STU-BLUESKY/Airplane/0、项目介绍/第一代无人机.jpg

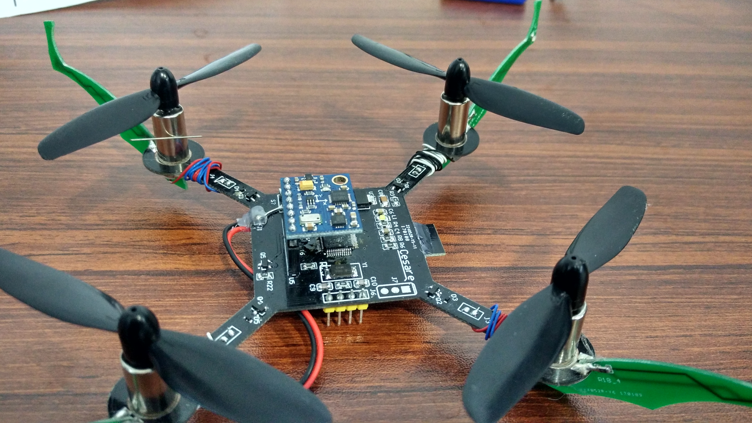
0、项目介绍/第一代无人机.jpg
