STU-BLUESKY/Airplane/3、无人机架构/无人机三代支架/效果图/机身.jpg

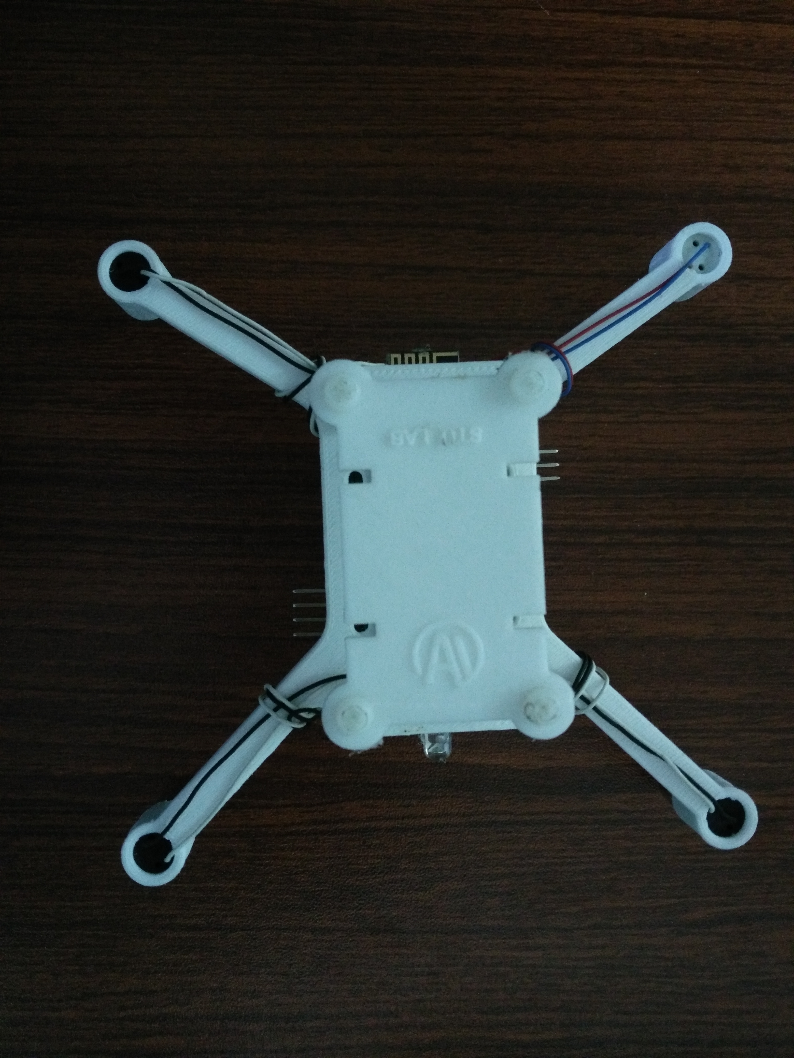
3、无人机架构/无人机三代支架/效果图/机身.jpg
