STU-BLUESKY/Airplane/5、宣传资料/安防无人机申报答辩PPT.pptx

基于STM32的安防无人机

负责人： 潘蓝根 团队成员：段一鸣 黄宇荣

## Slide 2

CONTENTS

目 录

ABOUT OUR TEAM

我们的分工

ABOUT OUR PREPERATION

项目前期准备

项目创新点

ABOUT OUR PLAN

实施方案

ATICIPATE RESULT

预期成果

FUTURE

经费预算

INNOVATION PIONT

## Slide 3

THE FIRST PART

我们的团队
ABOUT OUR TEAM

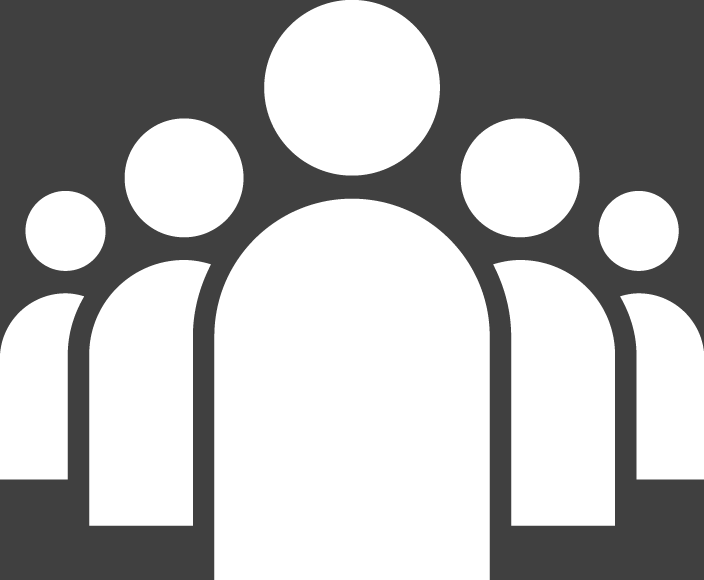
[picture p3: figure]

潘蓝根

15级电子信息工程
负责底层软件的开发

段一鸣

15级电子信息工程
电路设计

黄宇荣

15级电子信息工程
图像回传

## Slide 4

THE SECOND PART

前期准备
ABOUT OUR PREPARETION

①上网查找资料
(包括无人机行业的发展、无人机现状，开发无人机的关键技术和难点)
②分析项目可行性
③讨论项目进度安排、人员分工
④了解大概成本
⑤整理申报书

## Slide 5

THE THIRD PART

创新点
INNOVATION PIONT

创新难度

项目的创新点
1、配套遥控器，操作简单
2、成本低，功能比较全面
3、飞行稳定，安全性高

1

2

3

30%

50%

20%

## Slide 6

THE FOURTH PART

实施方案
STARTING PLAN

STEP ONE

STEP TWO

学习相关知识

搭建实验板

设计电路板

我们的计划
WHAT IS OUR PLAN

STEP THREE

STEP FOUR

开发底层软件，实现空中悬停（中期目标）

实现无人机的前后左右飞行

STEP FIVE

STEP SIX

开启摄像头，实现图像回传

## Slide 7

THE FOURTH PART

预期效果
ATICIPATE RESULT

1

实现无人机空中悬停

2

实现无人机的前后左右飞行

3

实现图像回传

## Slide 8

THE THIRD PART

经费预算
OUTLAY

任务 | | 经费（元）
实验板搭建，电子元器件的购买 | | 800
PCB板制作 | | 400
STM32学习板 | | 300
电池 | | 200
学习书籍购买 | | 100
其他 | | 100
总计 | | 1900

## Slide 9

THE FOURTH PART

可行性分析
FEASIBILITY ANALYSE

1

2

3

团队成员都有项目经验，对于项目的开发流程已经有了充分的了解

团队成员对无人机开发充满着兴趣，并且已经有了一定的无人机开发经验

本项目技术方案是在前人的基础上再进行改进，技术方案可行

## Slide 10

Q & A

THANK YOU
FOR WATCHING
