STU-BLUESKY/Airplane/0、项目介绍/第二代无人机.jpg

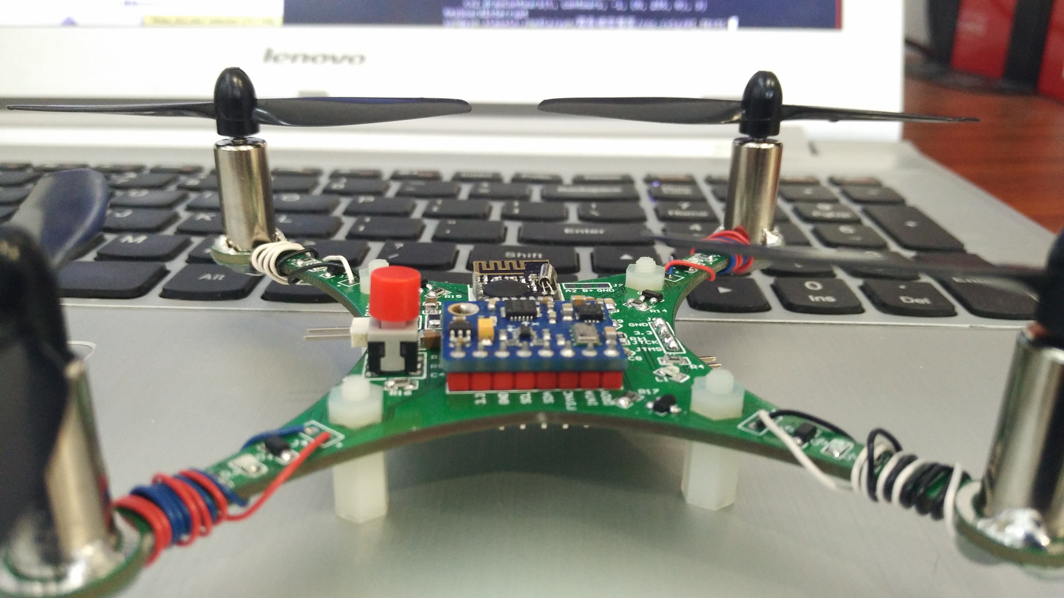
0、项目介绍/第二代无人机.jpg
