STU-BLUESKY/Airplane/0、项目介绍/遥控器.jpg

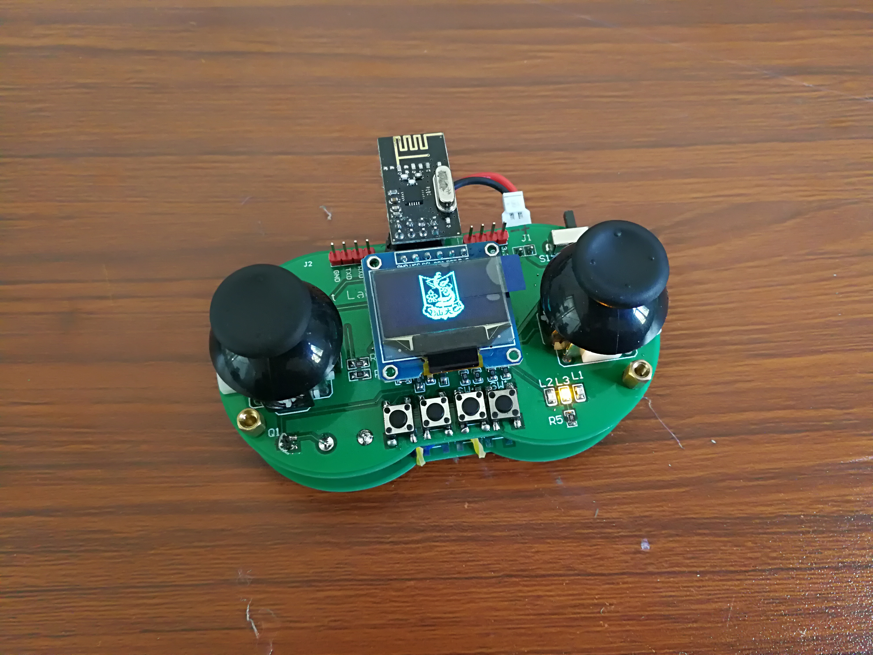
0、项目介绍/遥控器.jpg
