STU-BLUESKY/Airplane/3、无人机架构/无人机三代支架/效果图/支架05.PNG

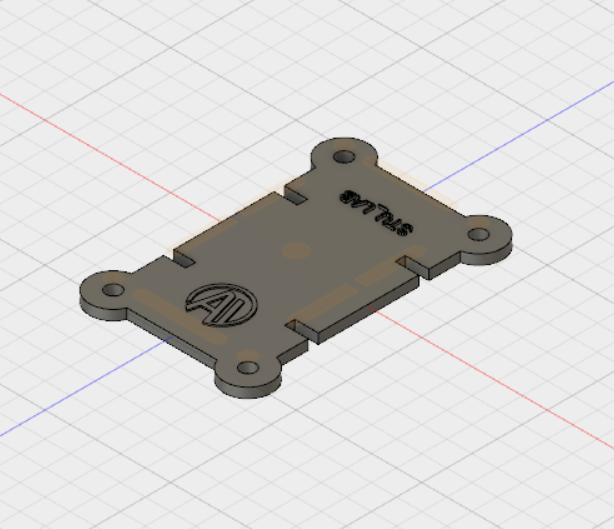
3、无人机架构/无人机三代支架/效果图/支架05.PNG
