STU-BLUESKY/Airplane/3、无人机架构/无人机二代支架/效果图/QQ图片20180321143831.jpg

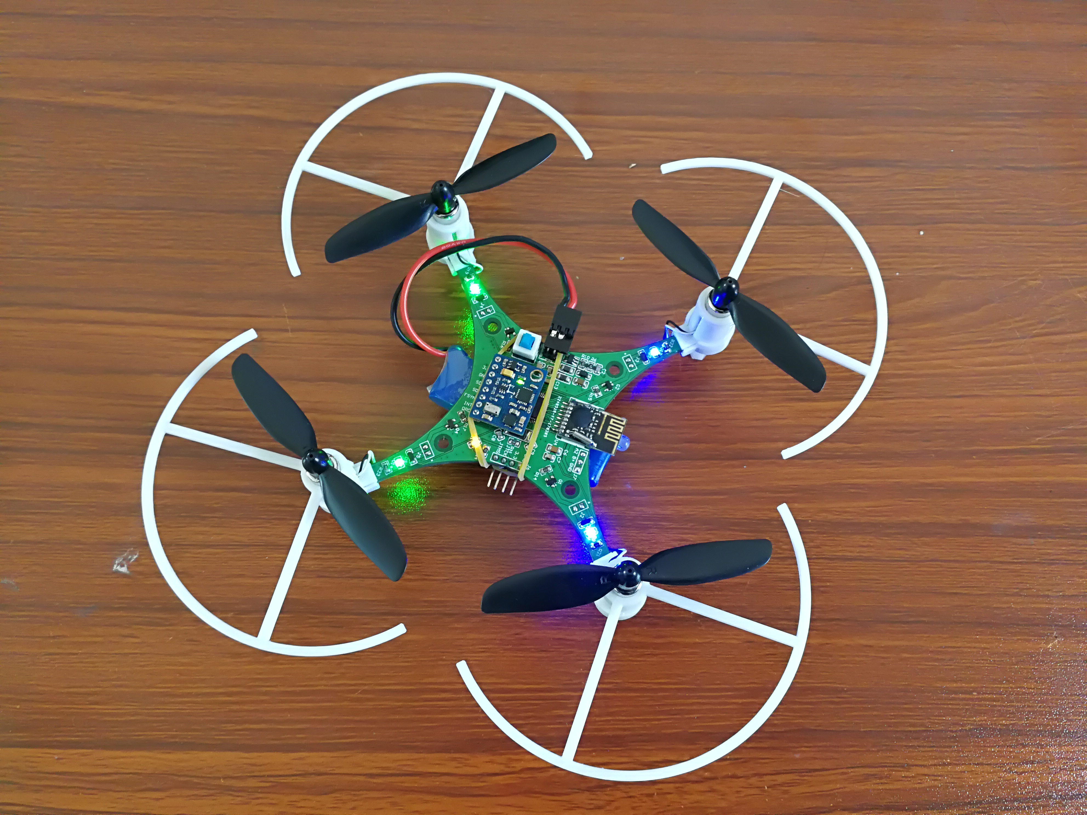
3、无人机架构/无人机二代支架/效果图/QQ图片20180321143831.jpg
