STU-BLUESKY/Airplane/3、无人机架构/无人机二代支架/效果图/支架02.PNG

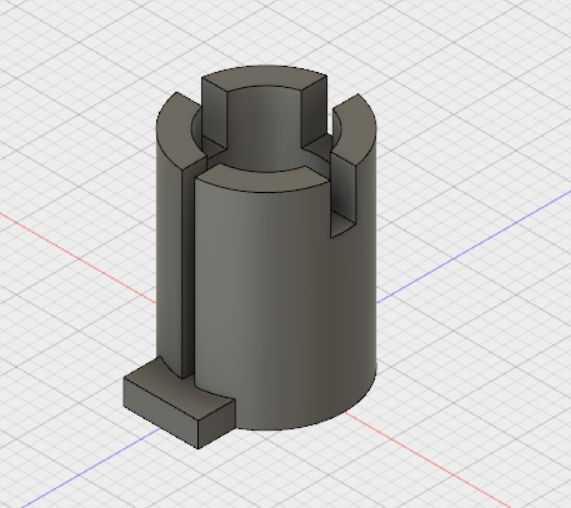
3、无人机架构/无人机二代支架/效果图/支架02.PNG
