STU-BLUESKY/Airplane/5、宣传资料/图片/1.PNG

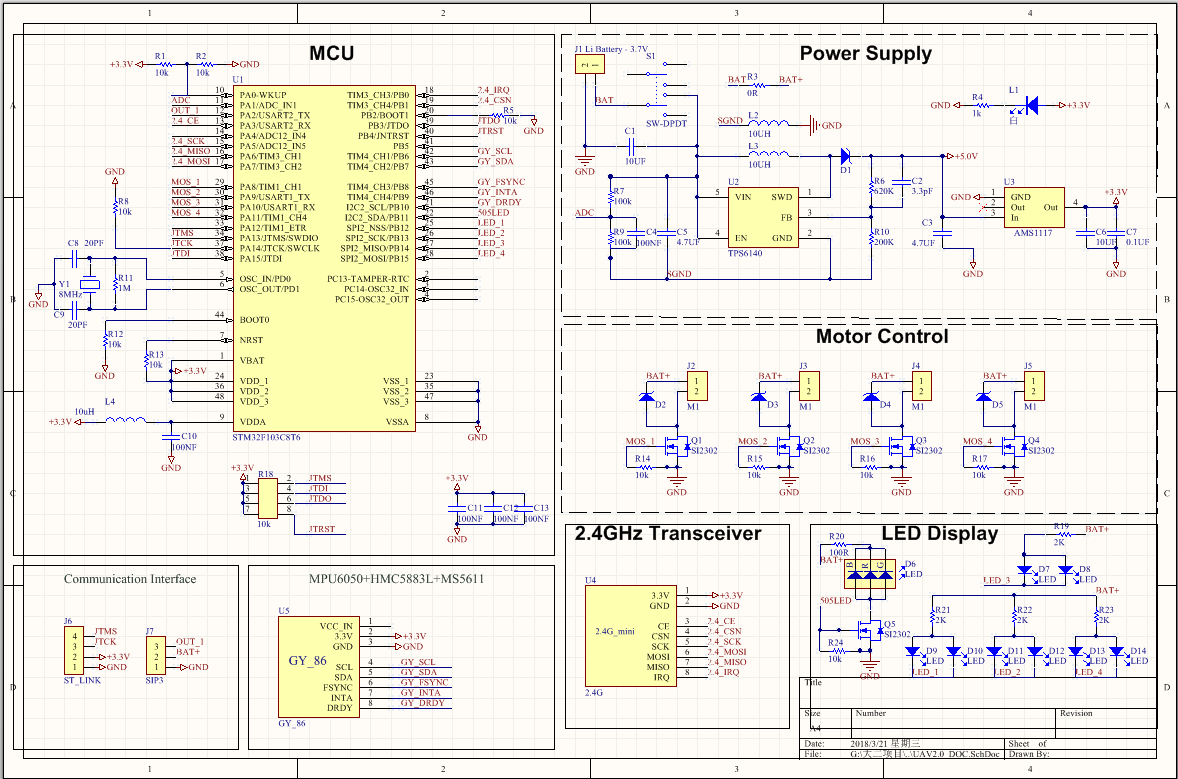
5、宣传资料/图片/1.PNG
