STU-BLUESKY/Airplane/5、宣传资料/图片/IMG_20180321_162717.jpg

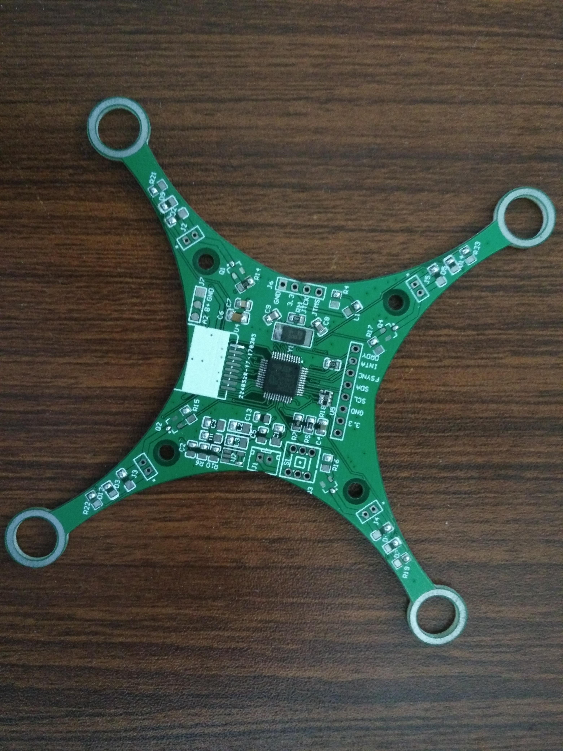
5、宣传资料/图片/IMG_20180321_162717.jpg
