STU-BLUESKY/Airplane/3、无人机架构/无人机三代支架/四轴支架.stl

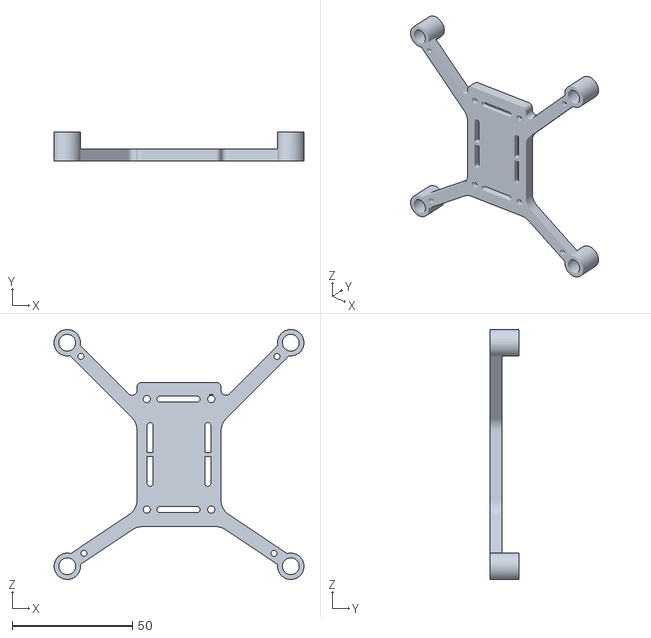
[picture p15: CAD file, 2018-04-16]
3、无人机架构/无人机三代支架/四轴支架.stl
103.9 x 12.0 x 103.9
