STU-BLUESKY/Airplane/3、无人机架构/无人机二代支架/STL模型/四轴护罩部件02.stl

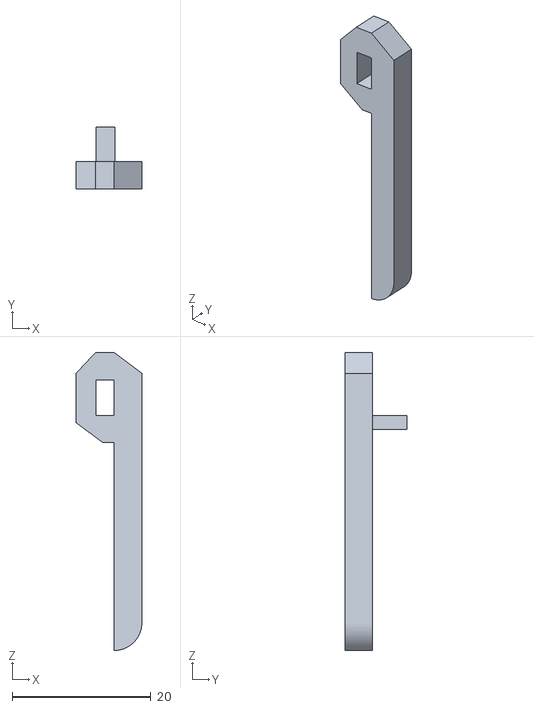
[picture p16: CAD file, 2018-04-16]
3、无人机架构/无人机二代支架/STL模型/四轴护罩部件02.stl
9.50 x 9.00 x 43.0
