STU-BLUESKY/Airplane/3、无人机架构/无人机二代支架/STL模型/四轴电机支架部件02.stl

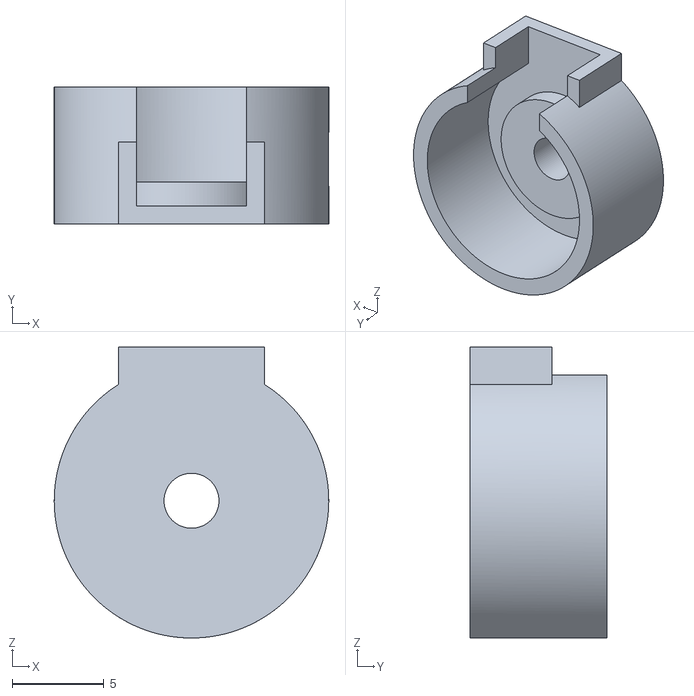
[picture p17: CAD file, 2018-04-16]
3、无人机架构/无人机二代支架/STL模型/四轴电机支架部件02.stl
15.0 x 7.50 x 15.9
