STU-BLUESKY/Airplane/3、无人机架构/无人机二代支架/STL模型/四轴电机支架部件01.stl

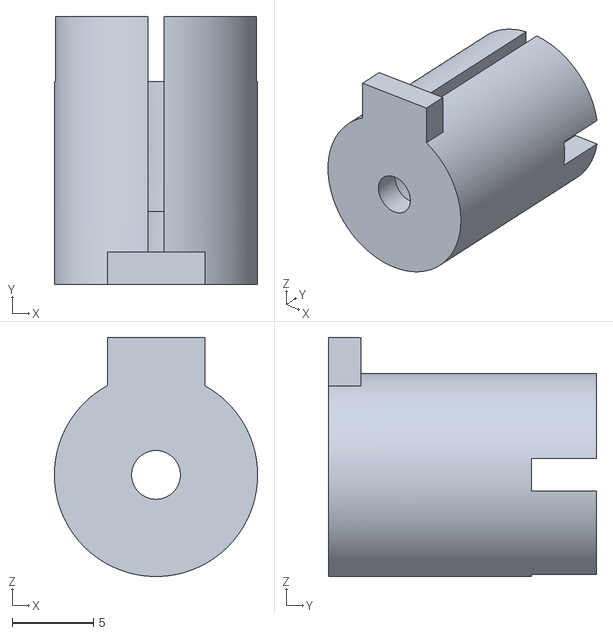
[picture p18: CAD file, 2018-04-16]
3、无人机架构/无人机二代支架/STL模型/四轴电机支架部件01.stl
12.5 x 16.5 x 14.7
