STU-BLUESKY/Airplane/3、无人机架构/无人机二代支架/STL模型/四轴护罩部件01.stl

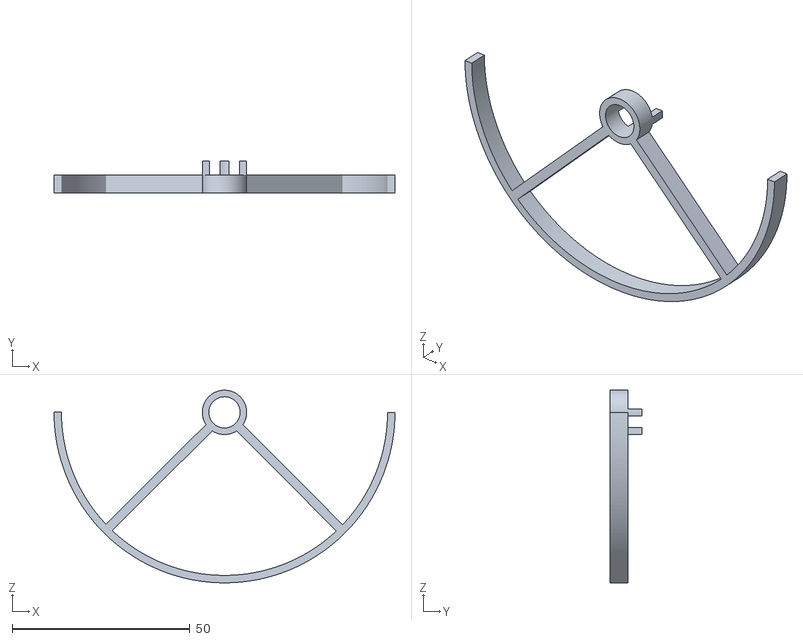
[picture p19: CAD file, 2018-04-16]
3、无人机架构/无人机二代支架/STL模型/四轴护罩部件01.stl
96.0 x 9.00 x 54.2
