STU-BLUESKY/Airplane/(list of files, cad)

Other CAD files:
3、无人机架构/无人机三代支架/四轴三代电池底板.f3d
3、无人机架构/无人机二代支架/AutodeskFusion360源文件/四轴护罩部件01.f3d
3、无人机架构/无人机二代支架/AutodeskFusion360源文件/四轴护罩部件02.f3d
3、无人机架构/无人机二代支架/AutodeskFusion360源文件/四轴电机支架部件01.f3d
3、无人机架构/无人机二代支架/AutodeskFusion360源文件/四轴电机支架部件02.f3d
