STU-BLUESKY/Airplane/(list of files, drawings)

Other design files:
1、硬件PCB/1、遥控器PCB/remote control.PcbDoc
1、硬件PCB/1、遥控器PCB/remote control.PcbLib
1、硬件PCB/1、遥控器PCB/remote control.PrjPCB
1、硬件PCB/1、遥控器PCB/remote control.SchDoc
1、硬件PCB/1、遥控器PCB/remote control.SchLib
1、硬件PCB/2、四轴第一代PCB/UAV1.0.PcbDoc
1、硬件PCB/2、四轴第一代PCB/UAV1.0.PrjPcb
1、硬件PCB/2、四轴第一代PCB/UAV1.0.SchDoc
1、硬件PCB/2、四轴第一代PCB/UAV1.0plus.PcbDoc
1、硬件PCB/3、四轴第二代PCB/UAV2.0_DOC.SchDoc
1、硬件PCB/3、四轴第二代PCB/UAV2.0_PR.PrjPCB
1、硬件PCB/3、四轴第二代PCB/UVA2.0 PCB.PcbDoc
1、硬件PCB/4、四轴第三代PCB/PCB-UVA-3.0.PcbDoc
1、硬件PCB/4、四轴第三代PCB/UAV3.0.PrjPcb
1、硬件PCB/4、四轴第三代PCB/UAV3.0_DOC.SchDoc
