STU-BLUESKY/Airplane/2、软件程序/2、四轴二代程序（PCB支架）/一鸣开发程序-可飞-待调控制方向/Master_FLY_3.0/Recieve_FLY/USER/control.h

#ifndef __CONTROL_H
#define __CONTROL_H
#include "sys.h"
  /**************************************************************************

**************************************************************************/
struct _pid{
        float kp;
			  float ki;
	      float kd;
	      float increment;
	      float increment_max;
	      float kp_out;
			  float ki_out;
	      float kd_out;
	      float pid_out;
          };

struct _tache{
    struct _pid shell;
    struct _pid core;	
          };
	

struct _ctrl{
		      u8  ctrlRate;
      struct _tache pitch;    
	    struct _tache roll;  
	    struct _tache yaw;   
            };

extern struct _ctrl ctrl;
/////////////////////////////
void TIM3_IRQHandler(void) ;
void CONTROL(float rol, float pit, float yaw);

#endif
