STU-BLUESKY/Airplane/2、软件程序/2、四轴二代程序（PCB支架）/宇荣开发程序/HARDWARE/MPU6050/mpu6050.c

#include "mpu6050.h"
#include "IIC.h"
#include "HMC5883L.h"

struct _sensor sensor;
float z_NED;

/************************************
	初始化MPU6050
	返回值:0,成功
  其他,错误代码
*******************************************/
u8 MPU_Init(void)
{ 
	u8 res;	
	RCC_APB2PeriphClockCmd(RCC_APB2Periph_AFIO,ENABLE);//使能AFIO时钟 
	
	I2C_GPIO_Configuration();			//初始化IIC总线
  delay_ms(100);
	I2C_WriteByte( MPU_WRITE,MPU_PWR_MGMT1_REG,0X00);	//唤醒MPU6050 
	MPU_Set_Gyro_Fsr(2);					//陀螺仪传感器,±1000dps
	MPU_Set_Accel_Fsr(0);					//加速度传感器,±2g
	MPU_Set_Rate(50);							//设置采样率50Hz
	I2C_WriteByte( MPU_WRITE,MPU_INT_EN_REG,0X00);	//关闭所有中断
	I2C_WriteByte( MPU_WRITE,MPU_USER_CTRL_REG,0X40);	//I2C主模式关闭
	I2C_WriteByte( MPU_WRITE,MPU_FIFO_EN_REG,0X00);	//关闭FIFO
	I2C_WriteByte( MPU_WRITE,MPU_INTBP_CFG_REG,0X42);	//INT引脚低电平有效		
	res=I2C_ReadByte( MPU_WRITE,MPU_DEVICE_ID_REG);
	if(res==MPU_ADDR)
  { 
			I2C_WriteByte( MPU_WRITE,MPU_PWR_MGMT1_REG,0X01);	//设置CLKSEL,PLL X轴为参考
			I2C_WriteByte( MPU_WRITE,MPU_PWR_MGMT2_REG,0X00);	//加速度与陀螺仪都工作
			MPU_Set_Rate(50);						//设置采样率为50Hz
		
		  GPIO_ResetBits(GPIOA, GPIO_Pin_0);
    	return 0;
  }
	else
	{ 
		return 1;
	}	
}


//设置MPU6050陀螺仪传感器满量程范围
//fsr:0,±250dps;1,±500dps;2,±1000dps;3,±2000dps
//返回值:0,设置成功
//    其他,设置失败 
u8 MPU_Set_Gyro_Fsr(u8 fsr)
{
	return I2C_WriteByte( MPU_WRITE,MPU_GYRO_CFG_REG,fsr<<3);//设置陀螺仪满量程范围  
}
//设置MPU6050加速度传感器满量程范围
//fsr:0,±2g;1,±4g;2,±8g;3,±16g
//返回值:0,设置成功
//    其他,设置失败 
u8 MPU_Set_Accel_Fsr(u8 fsr)
{
	return I2C_WriteByte( MPU_WRITE,MPU_ACCEL_CFG_REG,fsr<<3);//设置加速度传感器满量程范围  
}
//设置MPU6050的数字低通滤波器
//lpf:数字低通滤波频率(Hz)
//返回值:0,设置成功
//    其他,设置失败 
u8 MPU_Set_LPF(u16 lpf)
{
	u8 data=0;
	if(lpf>=188)data=1;
	else if(lpf>=98)data=2;
	else if(lpf>=42)data=3;
	else if(lpf>=20)data=4;
	else if(lpf>=10)data=5;
	else data=6; 
	return I2C_WriteByte( MPU_WRITE,MPU_CFG_REG,data);//设置数字低通滤波器  
}
//设置MPU6050的采样率(假定Fs=1KHz)
//rate:4~1000(Hz)
//返回值:0,设置成功
//    其他,设置失败 
u8 MPU_Set_Rate(u16 rate)
{
	u8 data;
	if(rate>1000)rate=1000;
	if(rate<4)rate=4;
	data=1000/rate-1;
	data=I2C_WriteByte( MPU_WRITE,MPU_SAMPLE_RATE_REG,data);	//设置数字低通滤波器
 	return MPU_Set_LPF(rate/2);	//自动设置LPF为采样率的一半
}

//得到温度值
//返回值:温度值(扩大了100倍)
short MPU_Get_Temperature(void)
{
    u8 buf[2]; 
    short raw;
	float temp;
	I2C_Read_Len(MPU_WRITE,MPU_TEMP_OUTH_REG,2,buf); 
    raw=((u16)buf[0]<<8)|buf[1];  
    temp=36.53+((double)raw)/340;  
    return temp*100;;
}
//得到陀螺仪值(原始值)
//gx,gy,gz:陀螺仪x,y,z轴的原始读数(带符号)
//返回值:0,成功
//    其他,错误代码
u8 MPU_Get_Gyroscope(short *gx,short *gy,short *gz)
{
    u8 buf[6],res;  
	res=I2C_Read_Len(MPU_WRITE,MPU_GYRO_XOUTH_REG,6,buf);
	if(res==0)
	{
		*gx=((u16)buf[0]<<8)|buf[1];  
		*gy=((u16)buf[2]<<8)|buf[3];  
		*gz=((u16)buf[4]<<8)|buf[5];
	} 	
    return res;
}
//得到加速度值(原始值)
//gx,gy,gz:陀螺仪x,y,z轴的原始读数(带符号)
//返回值:0,成功
//    其他,错误代码
u8 MPU_Get_Accelerometer(short *ax,short *ay,short *az)
{
  u8 buf[6],res;  
	res=I2C_Read_Len(MPU_WRITE,MPU_ACCEL_XOUTH_REG,6,buf);
	if(res==0)
	{
		*ax=((u16)buf[0]<<8)|buf[1];  
		*ay=((u16)buf[2]<<8)|buf[3];  
		*az=((u16)buf[4]<<8)|buf[5];
	} 	
    return res;
}

/*-------------------------------------------------
	 函数功能：采集MPU6050原始数据
-------------------------------------------------*/
void MPU6050_Getdata(void)
{
	int16_t aacx,aacy,aacz;		//加速度传感器原始数据
	int16_t gyrox,gyroy,gyroz;	//陀螺仪原始数据
	MPU_Get_Accelerometer(&aacx,&aacy,&aacz);	//得到加速度传感器数据
	MPU_Get_Gyroscope(&gyrox,&gyroy,&gyroz);	//得到陀螺仪数据
	
	sensor.acc.origin.x =	aacx-sensor.acc.quiet.x;
	sensor.acc.origin.y =	aacy-sensor.acc.quiet.y;
	sensor.acc.origin.z =	aacz-sensor.acc.quiet.z;												//z轴不需要减静态偏差
	sensor.gyro.origin.x = gyrox;
	sensor.gyro.origin.y = gyroy;
	sensor.gyro.origin.z = gyroz;
														
	sensor.gyro.cal.x = (sensor.gyro.origin.x-sensor.gyro.quiet.x)/GyroAxis_Sensitive ;
	sensor.gyro.cal.y = (sensor.gyro.origin.y-sensor.gyro.quiet.y)/GyroAxis_Sensitive ;
	sensor.gyro.cal.z = (sensor.gyro.origin.z-sensor.gyro.quiet.z)/GyroAxis_Sensitive ;	
	
	sensor.gyro.radian.x = sensor.gyro.cal.x*AtR;
	sensor.gyro.radian.y = sensor.gyro.cal.y*AtR;
	sensor.gyro.radian.z = sensor.gyro.cal.z*AtR;	
	
}


/*-------------------------------------
		函数功能：获取当前姿态角
-------------------------------------*/
void Get_Attitude(void)
{
	MPU6050_Getdata();
	
	sensor.acc.averag.x = KalmanFilter_x(sensor.acc.origin.x,KALMAN_Q,KALMAN_R);
	sensor.acc.averag.y = KalmanFilter_y(sensor.acc.origin.y,KALMAN_Q,KALMAN_R);
	sensor.acc.averag.z = KalmanFilter_z(sensor.acc.origin.z,KALMAN_Q,KALMAN_R);
	
	sensor.acc.cal.x  = sensor.acc.averag.x/AccAxis_Sensitive *10.0;
	sensor.acc.cal.y  = sensor.acc.averag.y/AccAxis_Sensitive *10.0;
	sensor.acc.cal.z  = sensor.acc.averag.z/AccAxis_Sensitive *10.0;				
	
	//Read_HMC5883L(&sensor.magnet.x,&sensor.magnet.y,&sensor.magnet.z);	//待调试
	Angle_Calculate(sensor.gyro.radian.x,
									sensor.gyro.radian.y,
									sensor.gyro.radian.z,
									sensor.acc.averag.x,
									sensor.acc.averag.y,
									sensor.acc.averag.z);		
	z_NED = DCMgb[0][2]* sensor.acc.cal.x + DCMgb[1][2]*sensor.acc.cal.y + DCMgb[2][2]*sensor.acc.cal.z;		
	
}

/*-------------------------------
		函数功能：采集陀螺仪零偏
--------------------------------*/
void Gyro_OFFSET(void)
{
   uint16_t cnt_g=0;
	 int32_t tempgx=100,tempgy=100,tempgz=100;
	 int16_t gx_last=0,gy_last=0,gz_last=0;
	 sensor.gyro.quiet.x=0;
	 sensor.gyro.quiet.y=0;
	 sensor.gyro.quiet.z=0;

	 while(tempgx>=100 || tempgy>=100 || tempgz>=100)	//此循环是确保四轴处于完全静止状态
	 {
		 tempgx=0;tempgy=0;tempgz=0;cnt_g=100;
		 while(cnt_g--)
		 {
			  MPU6050_Getdata();	
			 
	      tempgx += FL_ABS(sensor.gyro.origin.x - gx_last);
			  tempgy += FL_ABS(sensor.gyro.origin.y - gy_last);
			  tempgz += FL_ABS(sensor.gyro.origin.z - gz_last);
	
			  gx_last = sensor.gyro.origin.x;
			  gy_last = sensor.gyro.origin.y;
			  gz_last =	sensor.gyro.origin.z;
	     }	 
	 }
	 tempgx=0;tempgy=0;tempgz=0;cnt_g=2000;

 	 while(cnt_g--)	 //此循环进行陀螺仪标定，前提是四轴已经处于完全静止状态
	 {
		  MPU6050_Getdata();
	
      tempgx += sensor.gyro.origin.x;
		  tempgy += sensor.gyro.origin.y;
		  tempgz += sensor.gyro.origin.z;
     }

	 sensor.gyro.quiet.x = tempgx/2000;
	 sensor.gyro.quiet.y = tempgy/2000;
	 sensor.gyro.quiet.z = tempgz/2000;	
}
/*-------------------------------
		函数功能：校准加速度计
--------------------------------*/
void Acc_OFFSET(void)
{
		int32_t	tempax=0,tempay=0,tempaz=0;
		uint16_t cnt_a=200;
		sensor.acc.quiet.x = 0;
		sensor.acc.quiet.y = 0;
		sensor.acc.quiet.z = 0;

		while(cnt_a--)
		{
				MPU6050_Getdata();
				tempax+= sensor.acc.origin.x;
				tempay+= sensor.acc.origin.y;
				tempaz+= sensor.acc.origin.z;						
		}	
		sensor.acc.quiet.x = tempax/200;
		sensor.acc.quiet.y = tempay/200;
		sensor.acc.quiet.z = tempaz/200 - CONSTANTS_ONE_G/10*AccAxis_Sensitive; 	//当地重力加速度除以10，乘以测量灵敏度
			
}

/*-------------------------------------
		函数功能：KalmanFilter
		函数说明：X轴,Y轴,Z轴 原始数据卡尔曼滤波
-------------------------------------*/
static double KalmanFilter_x(const double ResrcData,double ProcessNiose_Q,double MeasureNoise_R)
{
   double R = MeasureNoise_R;
   double Q = ProcessNiose_Q;
   static double x_last;
   double x_mid = x_last;
   double x_now;
   static double p_last;
   double p_mid ;
   double p_now;
   double kg;        

   x_mid=x_last; //x_last=x(k-1|k-1),x_mid=x(k|k-1)
   p_mid=p_last+Q; //p_mid=p(k|k-1),p_last=p(k-1|k-1),Q=噪声
   kg=p_mid/(p_mid+R); //kg为kalman filter，R为噪声
   x_now=x_mid+kg*(ResrcData-x_mid);//估计出的最优值
                
   p_now=(1-kg)*p_mid;//最优值对应的covariance       
   p_last = p_now; //更新covariance值
   x_last = x_now; //更新系统状态值
   return x_now;                
}

static double KalmanFilter_y(const double ResrcData,double ProcessNiose_Q,double MeasureNoise_R)
{
   double R = MeasureNoise_R;
   double Q = ProcessNiose_Q;
   static double x_last;
   double x_mid = x_last;
   double x_now;
   static double p_last;
   double p_mid ;
   double p_now;
   double kg;        

   x_mid=x_last; //x_last=x(k-1|k-1),x_mid=x(k|k-1)
   p_mid=p_last+Q; //p_mid=p(k|k-1),p_last=p(k-1|k-1),Q=噪声
   kg=p_mid/(p_mid+R); //kg为kalman filter，R为噪声
   x_now=x_mid+kg*(ResrcData-x_mid);//估计出的最优值
                
   p_now=(1-kg)*p_mid;//最优值对应的covariance       
   p_last = p_now; //更新covariance值
   x_last = x_now; //更新系统状态值
   return x_now;                
}

static double KalmanFilter_z(const double ResrcData,double ProcessNiose_Q,double MeasureNoise_R)
{
   double R = MeasureNoise_R;
   double Q = ProcessNiose_Q;
   static double x_last = CONSTANTS_ONE_G/10*AccAxis_Sensitive; //z轴赋予初始值，加快z轴初始化的变化
   double x_mid = x_last;
   double x_now;
   static double p_last;
   double p_mid ;
   double p_now;
   double kg;        

   x_mid=x_last; //x_last=x(k-1|k-1),x_mid=x(k|k-1)
   p_mid=p_last+Q; //p_mid=p(k|k-1),p_last=p(k-1|k-1),Q=噪声
   kg=p_mid/(p_mid+R); //kg为kalman filter，R为噪声
   x_now=x_mid+kg*(ResrcData-x_mid);//估计出的最优值
                
   p_now=(1-kg)*p_mid;//最优值对应的covariance       
   p_last = p_now; //更新covariance值
   x_last = x_now; //更新系统状态值
   return x_now;                
}
