STU-BLUESKY/Airplane/2、软件程序/1、遥控器程序/HARDWARE/OLED/oled_BMP.h

#include "stm32f10x.h"

/*********************************************/
/*	BMP图像																	 */
/*																					 */
/*********************************************/
//取模方式：列行式 
//取模走向：逆向
//数据格式：C51格式
/**图片宽度像素要数清楚**/


unsigned char bmp_test[]=		
{	
0x00,0x00,0x00,0xFE,0xFE,0xFC,0x0C,0x18,0x10,0x30,0x30,0x20,0x60,0x60,0x40,0xC0,
0x80,0x80,0x80,0x80,0x80,0xE0,0xF0,0xF0,0xFE,0x7F,0x77,0x73,0x33,0x26,0x80,0x80,
0x80,0xC0,0xC0,0x40,0x60,0x60,0x30,0x30,0x18,0x18,0x1C,0x0C,0xFC,0xFE,0x00,0x00,
0x00,0x00,0x00,0x00,0x00,0xFF,0xFF,0xFF,0x00,0x00,0x00,0x00,0x02,0x16,0x2F,0x4B,
0xDB,0xB1,0xA1,0x61,0x41,0xFD,0xFF,0xFF,0xFF,0xF7,0x3E,0x1E,0x86,0xE2,0xE3,0x71,
0x71,0xB1,0xF0,0xF0,0xF0,0xF8,0x3F,0x1E,0x00,0x00,0x00,0x00,0x00,0x00,0xFF,0xFF,
0x00,0x00,0x00,0x00,0x00,0x00,0x00,0xFF,0xFF,0xFF,0x00,0x00,0x00,0x00,0x00,0x80,
0xC0,0x60,0xE0,0x81,0x0B,0x0B,0x0E,0x0D,0x07,0x07,0x0F,0x1F,0xFE,0xFC,0x9B,0x9B,
0xF7,0xF7,0xB7,0xB7,0xF3,0x71,0xFC,0xD0,0xF0,0xE1,0x73,0x3E,0x1C,0x00,0x00,0x00,
0xFF,0xFF,0x00,0x00,0x00,0x00,0x00,0x00,0x00,0xFF,0xFF,0xFF,0x00,0x70,0xF8,0xD8,
0x8B,0x8F,0xF9,0x18,0x19,0xFF,0x8B,0x88,0xD8,0xF0,0x60,0x00,0x00,0x00,0xFF,0xFF,
0x01,0x01,0x0D,0x3E,0x7B,0x73,0x7B,0x7C,0x3F,0x9F,0xFF,0xFF,0xFF,0xFC,0xF8,0xC0,
0x00,0x00,0xFF,0xFF,0x00,0x00,0x00,0x00,0x00,0x00,0x00,0xFF,0xFF,0xFF,0x80,0x80,
0x0C,0x1E,0x13,0x11,0x1F,0x03,0x1F,0x1D,0x13,0x16,0x9C,0x88,0xCC,0xDE,0xDE,0xDF,
0xFF,0xFF,0xBE,0xBE,0xBE,0xBE,0xBE,0x9E,0x9E,0xDE,0xCF,0xE7,0xF3,0xFD,0xFF,0x7F,
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
0x04,0x04,0x04,0x04,0x04,0x04,0x04,0x04,0x04,0x03,0x01,0x00,0x00,0x00,0x00,0x00,
};

unsigned char bmp_battery_line[] =
{
0xFF,
};

unsigned char bmp_battery_no[] =
{
0x00,
};

unsigned char bmp_battery_head[] =							//宽度4 高度8
{	
0xFF,0x4E,0x42,0x7E
};
