STU-BLUESKY/Airplane/2、软件程序/1、遥控器程序/HARDWARE/OLED/oled_CN.h

#include "stm32f10x.h"
/**********************************/
/*	中文字库											*/
/**********************************/
//取模方式：列行式 
//取模走向：逆向
//数据格式：C51格式
//大小 16*16
//**********************************

unsigned char Hzk[][32]=
{
//模式 01
{0x10,0x10,0xD0,0xFF,0x90,0x14,0xE4,0xAF,0xA4,0xA4,0xA4,0xAF,0xE4,0x04,0x00,0x00},
{0x04,0x03,0x00,0xFF,0x00,0x89,0x4B,0x2A,0x1A,0x0E,0x1A,0x2A,0x4B,0x88,0x80,0x00},/*"?",2*/
{0x10,0x10,0x90,0x90,0x90,0x90,0x90,0x10,0x10,0xFF,0x10,0x10,0x11,0x16,0x10,0x00},
{0x00,0x20,0x60,0x20,0x3F,0x10,0x10,0x10,0x00,0x03,0x0C,0x10,0x20,0x40,0xF8,0x00},/*"?",3*/

//控制 23
{0x10,0x10,0x10,0xFF,0x90,0x20,0x98,0x48,0x28,0x09,0x0E,0x28,0x48,0xA8,0x18,0x00},
{0x02,0x42,0x81,0x7F,0x00,0x40,0x40,0x42,0x42,0x42,0x7E,0x42,0x42,0x42,0x40,0x00},/*"?",0*/
{0x40,0x50,0x4E,0x48,0x48,0xFF,0x48,0x48,0x48,0x40,0xF8,0x00,0x00,0xFF,0x00,0x00},
{0x00,0x00,0x3E,0x02,0x02,0xFF,0x12,0x22,0x1E,0x00,0x0F,0x40,0x80,0x7F,0x00,0x00},/*"?",1*/

//调试 45
{0x40,0x42,0xCC,0x00,0x00,0xFE,0x82,0x92,0x92,0xFE,0x92,0x92,0x82,0xFE,0x00,0x00},
{0x00,0x00,0x3F,0x10,0x88,0x7F,0x00,0x1E,0x12,0x12,0x12,0x5E,0x80,0x7F,0x00,0x00},/*"?",0*/
{0x40,0x40,0x42,0xCC,0x00,0x90,0x90,0x90,0x90,0x90,0xFF,0x10,0x11,0x16,0x10,0x00},
{0x00,0x00,0x00,0x3F,0x10,0x28,0x60,0x3F,0x10,0x10,0x01,0x0E,0x30,0x40,0xF0,0x00},/*"?",1*/

//反馈 67
{0x00,0x00,0xFC,0x24,0x24,0xE4,0x24,0x24,0x22,0x22,0x22,0xA3,0x62,0x00,0x00,0x00},
{0x40,0x30,0x8F,0x80,0x40,0x40,0x23,0x14,0x08,0x14,0x22,0x41,0x40,0x80,0x80,0x00},/*"?",0*/
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
{0x11,0xF2,0x00,0x00,0xFF,0x21,0xA9,0xBD,0xA9,0x21,0xFF,0x00},
{0x00,0x07,0x02,0x08,0x07,0x00,0x03,0x02,0x0B,0x08,0x0F,0x00},/*"?",2*/
{0x11,0xF2,0x00,0x00,0x24,0xE4,0x24,0x04,0xFF,0x04,0x05,0x00},
{0x00,0x0F,0x04,0x00,0x04,0x07,0x02,0x00,0x03,0x04,0x0E,0x00},/*"?",3*/

};
