STU-BLUESKY/Airplane/2、软件程序/2、四轴二代程序（PCB支架）/宇荣开发程序/HARDWARE/TIMER/timer.h

#include "stm32f10x.h"

extern uint8_t  loop200HzFlag, loop100HzFlag, loop50HzFlag, loop10HzFlag;
extern volatile uint16_t loop200HzCnt, loop100HzCnt, loop50HzCnt, loop10HzCnt;

void TIM3_Config(unsigned short int Period,unsigned short int Prescaler);
void TIM2_Config(unsigned short int Period,unsigned short int Prescaler);
