STU-BLUESKY/Airplane/2、软件程序/2、四轴二代程序（PCB支架）/一鸣开发程序-可飞-待调控制方向/Master_FLY_3.0/Recieve_FLY/USER/IMU.h

#ifndef __IMU_H
#define	__IMU_H
#include "stm32f10x.h"


#define RtA 		57.324841				
#define AtR    	0.0174533				
#define Acc_G 	0.0011963				
#define Gyro_G 	0.03051756				
#define Gyro_Gr	0.0005426


struct _angle{
        float pitch;
				float roll;
        float yaw;};


extern struct _angle angle;
			
float FL_ABS(float x);
void Prepare_Data(void);
void Get_Attitude(void);
void IMUupdate(float gx, float gy, float gz, float ax, float ay, float az);
//static double KalmanFilter_z(const double ResrcData,double ProcessNiose_Q,double MeasureNoise_R);
#endif
