STU-BLUESKY/Airplane/2、软件程序/2、四轴二代程序（PCB支架）/一鸣开发程序-可飞-待调控制方向/Master_FLY_3.0/Recieve_FLY/USER/SPI.h

#ifndef __SPI_H
#define __SPI_H
#include "sys.h"


 
 				  	    													  
void SPI1_Init(void);			 //初始化SPI口
void SPI1_SetSpeed(u8 SpeedSet); //设置SPI速度   
u8 SPI1_ReadWriteByte(u8 TxData);//SPI总线读写一个字节
		 
#endif
