STU-BLUESKY/Airplane/2、软件程序/2、四轴二代程序（PCB支架）/一鸣开发程序-可飞-待调控制方向/Master_FLY_3.0/Recieve_FLY/USER/timer.c

/******************** (C) COPYRIGHT 2014 Air Nano Team ***************************
 * 文件名  ：time.c
 * 描述    ：TIM3配置         
 * 实验平台：Air Nano四轴飞行器
 * 库版本  ：ST3.5.0
 * 作者    ：Air Nano Team 
 * 淘宝    ：http://byd2.taobao.com
**********************************************************************************/
#include "timer.h"
#include "stm32f10x.h"


/**************************实现函数********************************************
*函数原型:		
*功　　能:1ms中断一次,计数器为1000		
*******************************************************************************/
void TIM3_Init(u16 period_num)
{
	TIM_TimeBaseInitTypeDef TIM_TimeBaseStructure;
	//基础设置，时基和比较输出设置，由于这里只需定时，所以不用OC比较输出
	RCC_APB1PeriphClockCmd(RCC_APB1Periph_TIM3,ENABLE);
	
	TIM_DeInit(TIM3);

	TIM_TimeBaseStructure.TIM_Period=period_num;//装载值
	//prescaler is 1200,that is 72000000/72/500=2000Hz;
	TIM_TimeBaseStructure.TIM_Prescaler=72-1;//分频系数
	//set clock division 
	TIM_TimeBaseStructure.TIM_ClockDivision=TIM_CKD_DIV1; //or TIM_CKD_DIV2 or TIM_CKD_DIV4
	//count up
	TIM_TimeBaseStructure.TIM_CounterMode=TIM_CounterMode_Up;
	
	TIM_TimeBaseInit(TIM3,&TIM_TimeBaseStructure);
	//clear the TIM2 overflow interrupt flag
	TIM_ClearFlag(TIM3,TIM_FLAG_Update);
	//TIM2 overflow interrupt enable
	TIM_ITConfig(TIM3,TIM_IT_Update,ENABLE);
	//enable TIM2
	TIM_Cmd(TIM3,DISABLE);
}
void Nvic_Init(void)
{
	NVIC_InitTypeDef NVIC_InitStructure;
	
	/* NVIC_PriorityGroup */
	NVIC_PriorityGroupConfig(NVIC_PriorityGroup_2);
	
	NVIC_InitStructure.NVIC_IRQChannel=TIM3_IRQn;
	NVIC_InitStructure.NVIC_IRQChannelPreemptionPriority = 2;
	NVIC_InitStructure.NVIC_IRQChannelSubPriority = 0;
	NVIC_InitStructure.NVIC_IRQChannelCmd = ENABLE;
	NVIC_Init(&NVIC_InitStructure);
	
	
	/* Enable the USARTy Interrupt */
	NVIC_InitStructure.NVIC_IRQChannel = USART1_IRQn;	 
	NVIC_InitStructure.NVIC_IRQChannelPreemptionPriority = 1;
	NVIC_InitStructure.NVIC_IRQChannelSubPriority = 0;
	NVIC_InitStructure.NVIC_IRQChannelCmd = ENABLE;
	NVIC_Init(&NVIC_InitStructure);
	

}
