STU-BLUESKY/Airplane/2、软件程序/2、四轴二代程序（PCB支架）/一鸣开发程序-可飞-待调控制方向/Master_FLY_3.0/Recieve_FLY/USER/timer.h

#ifndef __TIME_H__
#define __TIME_H__
#include "stm32f10x.h"

#define EnTIM3()  TIM_Cmd(TIM3,ENABLE)
#define DISEnTIM3()  TIM_Cmd(TIM3,DISABLE)

void Nvic_Init(void);
void TIM3_Init(u16 period_num);

#endif 
