STU-BLUESKY/Airplane/(notices)

Notices in the files:
2、软件程序/1、遥控器程序/SYSTEM/usart/usart.c:
Copyright(C) ¹ãÖÝÊÐÐÇÒíµç×Ó¿Æ¼¼ÓÐÏÞ¹«Ë¾ 2009-2019
All rights reserved
